Huseyinogu/Buck-ve-Otesi/test_images/circuitphoto.jpeg

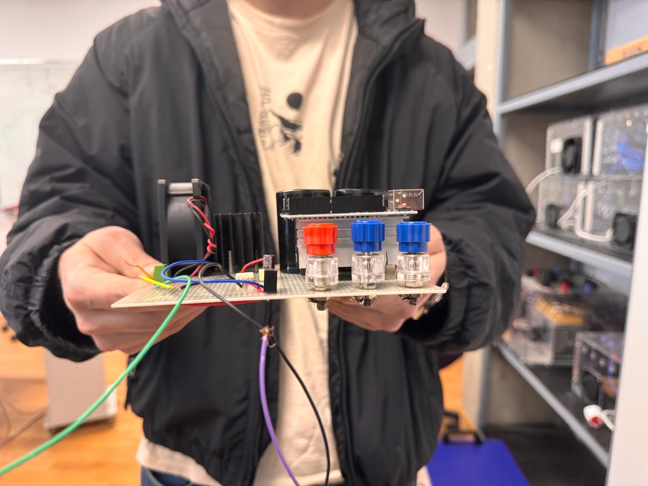
test_images/circuitphoto.jpeg
