Huseyinogu/Buck-ve-Otesi/test_images/circuitconnections.jpeg

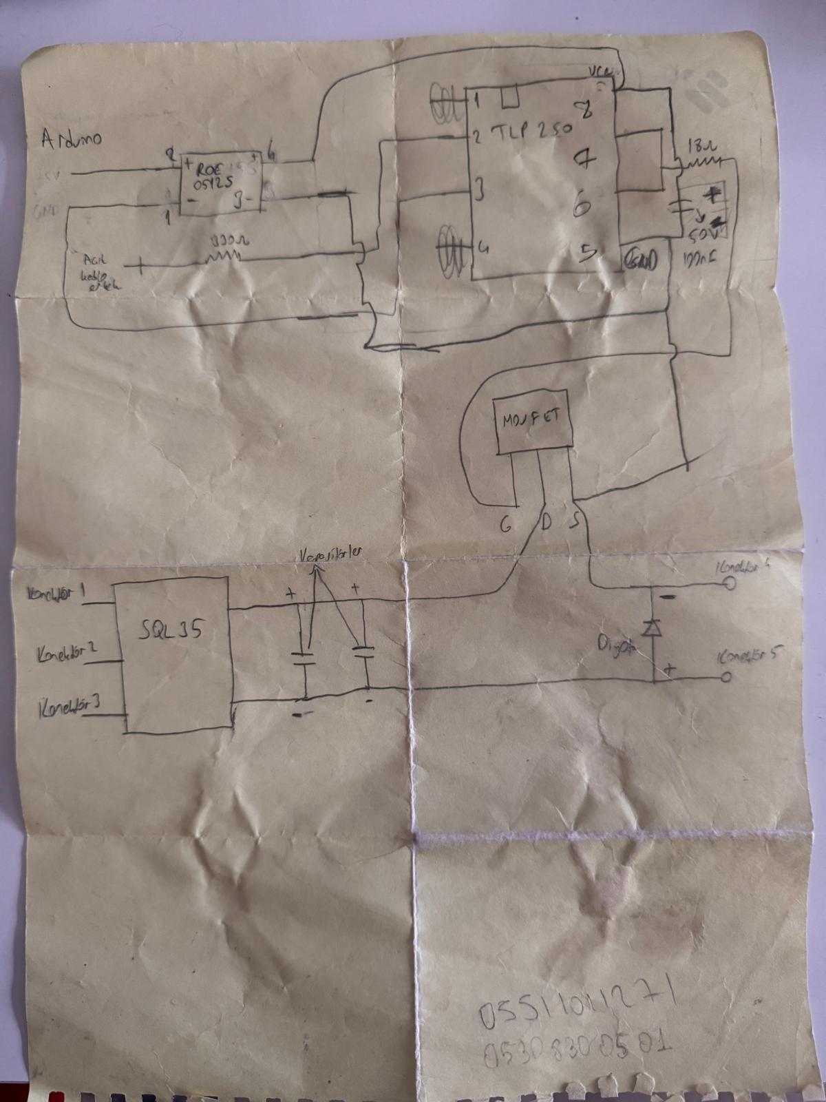
test_images/circuitconnections.jpeg
