Huseyinogu/Buck-ve-Otesi/Gate Driver Selection Final/EE463_Gate_Driver_Selection.pdf

# Evaluation of the TLP250 Optocoupler as a Gate

# Driver for the IXFH80N65X2 MOSFET

## 1 Introduction

This report presents a detailed technical evaluation of the TLP250 optocoupler used as a gate driver for the IXFH80N65X2 power MOSFET. The system operates at a switching frequency (fsw) of 2 kHz with a duty cycle of 0.85. The MOSFET is operated in a high-side

switching configuration, which introduces specific requirements for gate-drive referencing and power supply isolation. The design aims to ensure reliable gate drive operation, correct grounding behavior, acceptable switching performance, and safe operation of both the gate driver and the power device.

## 2 Component and Supply Parameters

### 2.1 MOSFET: IXFH80N65X2

- Drain–source voltage rating: VDSS = 650 V
- Continuous drain current at 25◦C: ID25 = 80 A
- Gate threshold voltage: VGS(th) = 3.5–5.0 V
- Gate-to-source charge: Qgs ≈ 50 nC
- Gate-to-drain (Miller) charge: Qgd ≈ 40 nC
- Total gate charge (datasheet, VGS = 10 V):

Qg ≈ 140 nC

### 2.2 Gate Driver: TLP250

- Maximum peak output current: IO = ±1.5 A
- Maximum input threshold current: IF LH = 5 mA

- Typical LED forward voltage: VF ≈ 1.6 V

## 3 Need for an Isolated DC–DC Converter

### 3.1 Grounding Problem in High-Side Switching

In a high-side switching topology, the source terminal of the MOSFET is not connected to the system ground. Instead, it is tied to the switching node, whose voltage varies dy-namically between the supply voltage and the load voltage during operation. As a result, the source potential is not fixed and may experience large and fast voltage transitions. Gate control of a MOSFET is defined by the gate-to-source voltage (VGS), not the

gate-to-ground voltage. If a non-isolated gate driver supply referenced to system ground were used, the gate driver would be unable to maintain a constant and well-defined VGS. This would lead to incorrect gate drive levels, unreliable switching behavior, and potential overstress of the MOSFET gate oxide.

### 3.2 Floating Gate Drive Requirement

To properly drive a high-side MOSFET, the gate driver supply must be referenced to the MOSFET source terminal and must therefore float with the switching node. This floating behavior ensures that the required positive gate-to-source voltage is maintained regardless of the instantaneous source voltage.
An isolated DC–DC converter provides this floating supply by electrically decoupling the gate-drive power domain from the control and system ground. The isolation prevents ground loops, eliminates common-mode voltage stress on the control circuitry, and allows the gate driver output to move together with the MOSFET source node.

### 3.3 Role of Isolation in System Safety and Reliability

In addition to enabling correct high-side operation, galvanic isolation improves system safety and robustness. The isolation barrier protects low-voltage control electronics from high-voltage transients present in the power stage and prevents destructive current paths caused by ground potential differences. Therefore, the isolated DC–DC converter is not an optional design choice but a functional requirement imposed by the high-side switching configuration.

## 4 Circuit Description and Design Calculations

### 4.1 Input Stage: Microcontroller to TLP250

A 330 Ω resistor is connected between the Arduino PWM output (5 V) and the TLP250

LED input to limit the forward current:

IF =

VIN − VF

Rin

=

5 − 1.6
330

≈ 10.3 mA

This current exceeds the minimum required input current of 5 mA, ensuring reliable optocoupler activation over temperature and supply variations.

### 4.2 Output Stage: TLP250 to MOSFET Gate

An 18 Ω gate resistor (RG) is placed between the TLP250 output pins and the MOSFET

gate to limit the peak gate current and control switching transients.

Ig,peak ≈

VCC
RG

=

15
18

≈ 0.83 A

This current level remains safely below the TLP250 maximum peak current rating.

### 4.3 Gate Charge and Turn-On Time Analysis

MOSFET switching behavior is governed by the total gate charge. According to the datasheet:

Qg = 140 nC

The turn-on transition time can be estimated as:

ton ≈

Qg

Ig,peak

=

140 nC
0.83 A

≈ 169 ns

This value includes the gate-to-source charging interval, the Miller plateau, and the post-Miller gate voltage rise.

### 4.4 Turn-Off Behavior

During turn-off, the gate charge is discharged through the same gate resistor. Given the switching frequency of 2 kHz, the available off-time of approximately 75 µs is several orders of magnitude longer than the required discharge time, ensuring full turn-off before the next switching cycle.

### 4.5 Power Supply Decoupling

Local decoupling capacitors are placed between VCC and GND of the TLP250:

- 0.1 µF ceramic capacitor for high-frequency decoupling
- 0.47 µF capacitor acting as a local energy buffer

## 5 Conclusion

The analysis demonstrates that the TLP250 optocoupler is suitable for driving the IXFH80N65X2 MOSFET in a high-side switching configuration at a switching frequency of 2 kHz. The
use of an isolated DC–DC converter is essential to provide a floating gate-drive supply, eliminate grounding conflicts, and ensure a well-defined gate-to-source voltage under all operating conditions. By correctly accounting for the total gate charge of 140 nC, the estimated switching times remain negligible relative to the switching period, confirming the validity and robustness of the proposed gate drive design.
