Huseyinogu/Buck-ve-Otesi/test_images/160V_Test_DC_Supply.jpeg

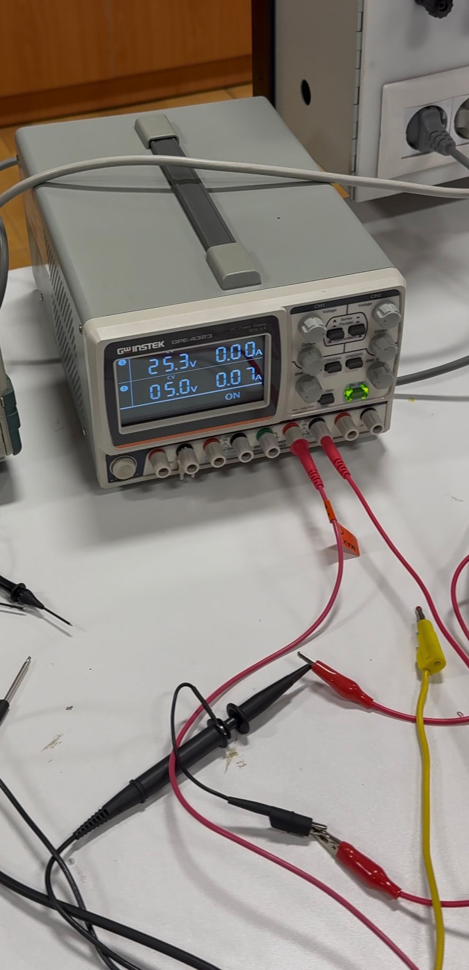
test_images/160V_Test_DC_Supply.jpeg
