Huseyinogu/Buck-ve-Otesi/test_images/160V_Test_MOSFET_Thermal_Camera.jpeg

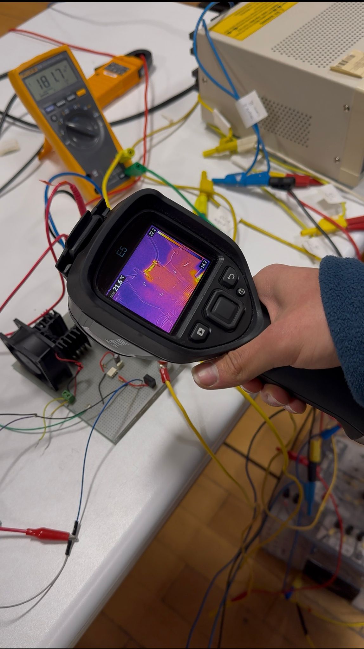
test_images/160V_Test_MOSFET_Thermal_Camera.jpeg
