Huseyinogu/Buck-ve-Otesi/test_images/160V_Test_Multimeter.jpeg

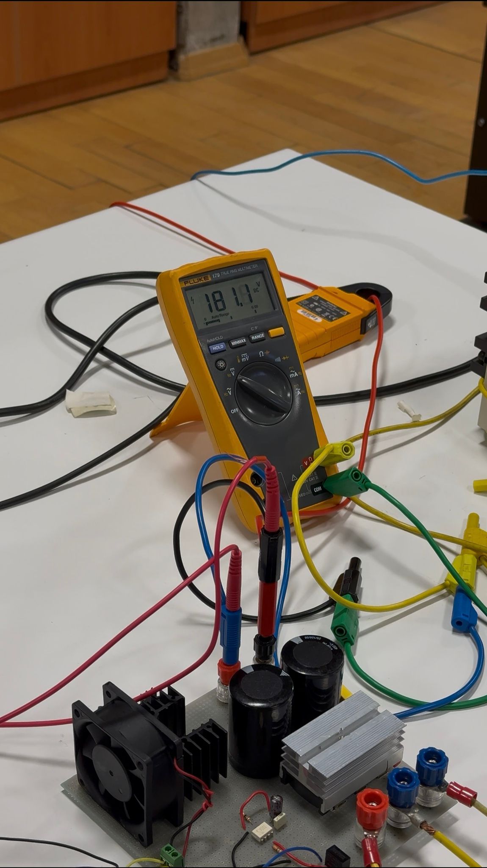
test_images/160V_Test_Multimeter.jpeg
