Huseyinogu/Buck-ve-Otesi/test_images/160V_Test_Oscilloscope.jpeg

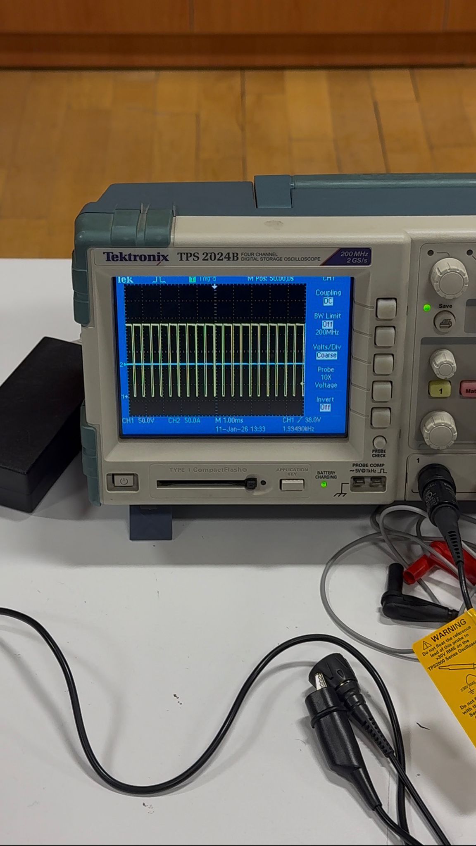
test_images/160V_Test_Oscilloscope.jpeg
