Huseyinogu/Buck-ve-Otesi/test_images/circuit.jpeg

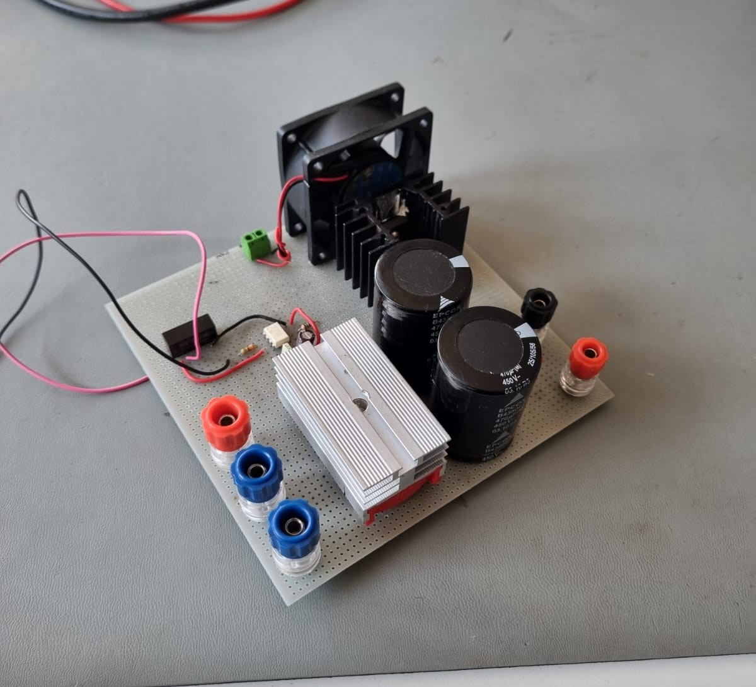
test_images/circuit.jpeg
