Huseyinogu/Buck-ve-Otesi/test_images/circuitphoto2.jpeg

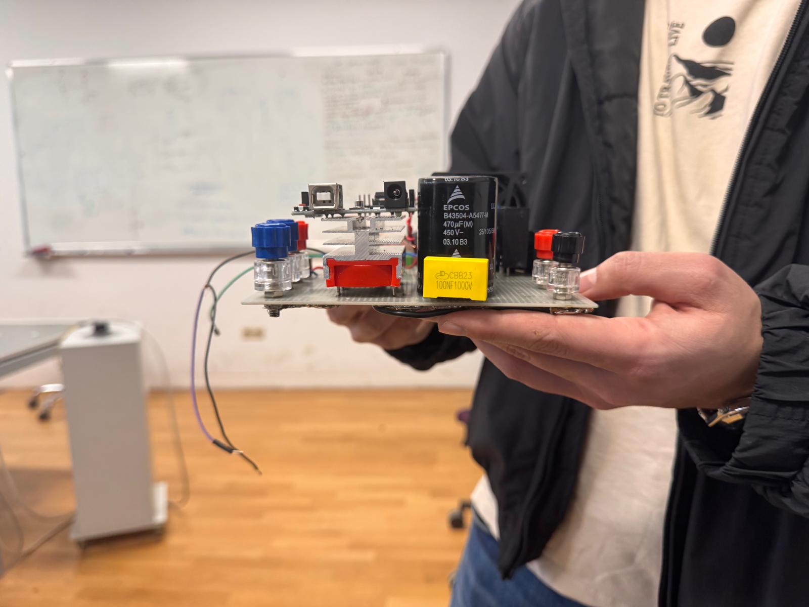
test_images/circuitphoto2.jpeg
