Huseyinogu/Buck-ve-Otesi/test_images/circuitphototop.jpeg

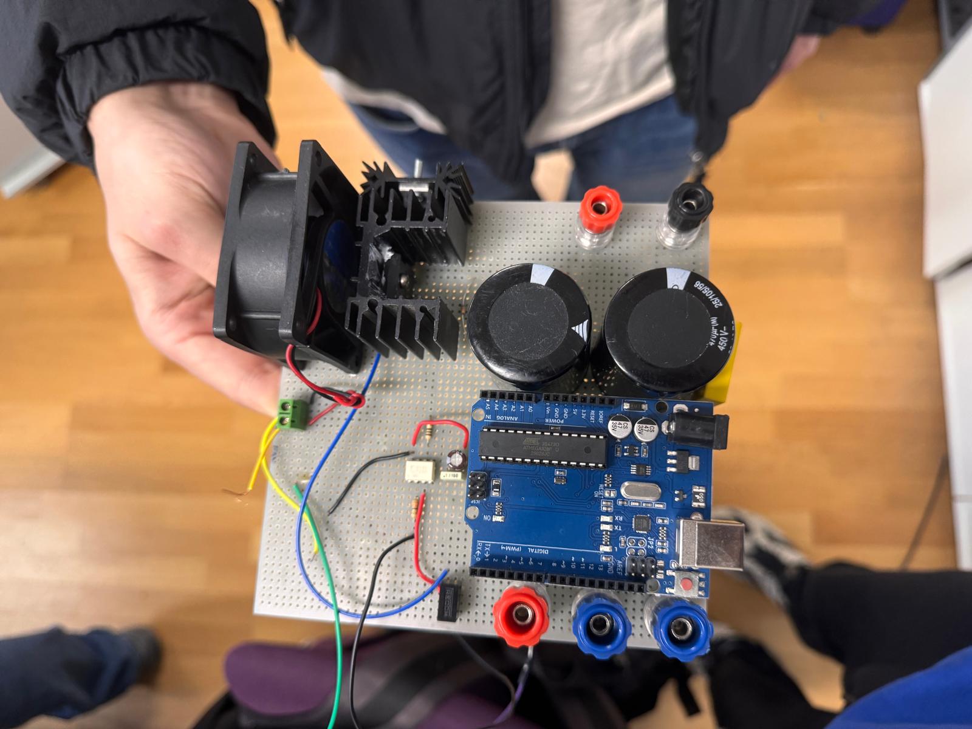
test_images/circuitphototop.jpeg
