Huseyinogu/Buck-ve-Otesi/test_images/Diode Rectifier in Kettle Bonus.jpeg

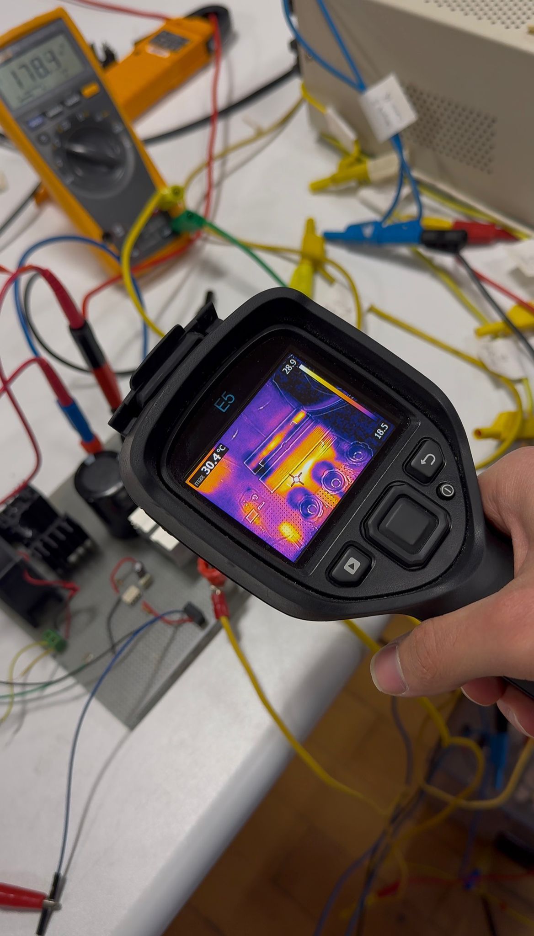
test_images/Diode Rectifier in Kettle Bonus.jpeg
