Huseyinogu/Buck-ve-Otesi/test_images/IMG_5116.jpeg

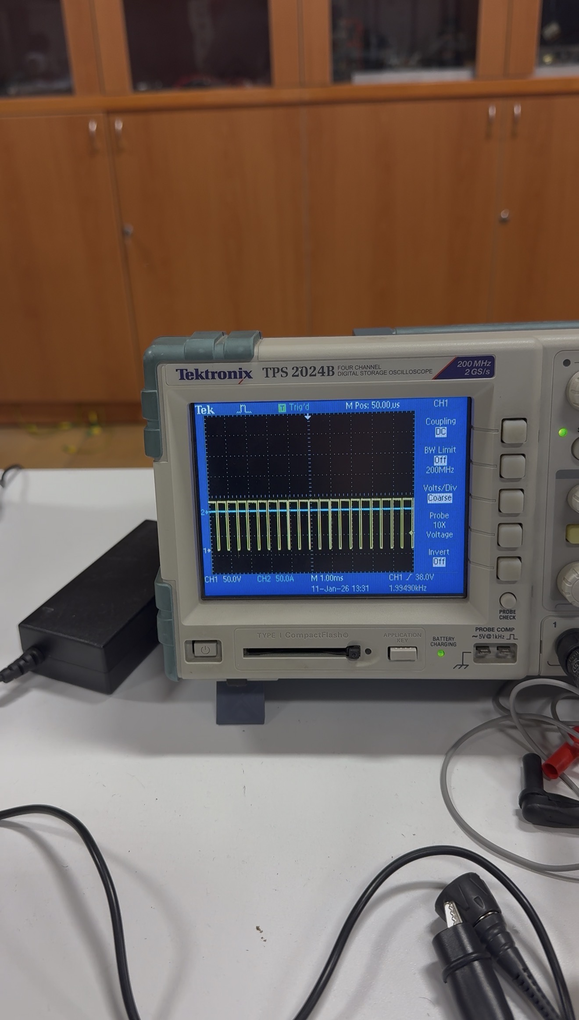
test_images/IMG_5116.jpeg
