Huseyinogu/Buck-ve-Otesi/test_images/IMG_5117.jpeg

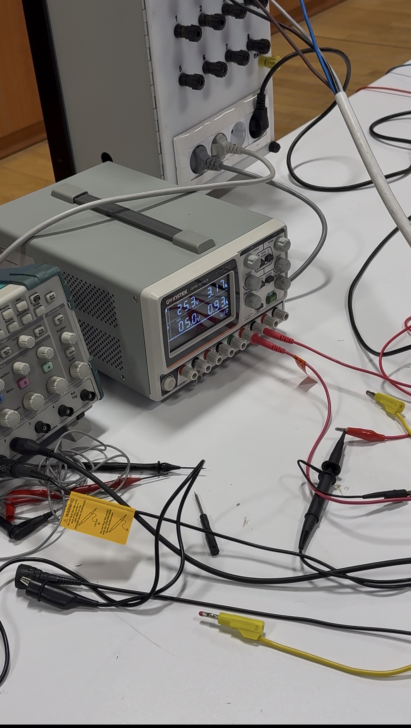
test_images/IMG_5117.jpeg
