Huseyinogu/Buck-ve-Otesi/test_images/Kettle and Oscilloscope in Kettle Bonus (initially).jpeg

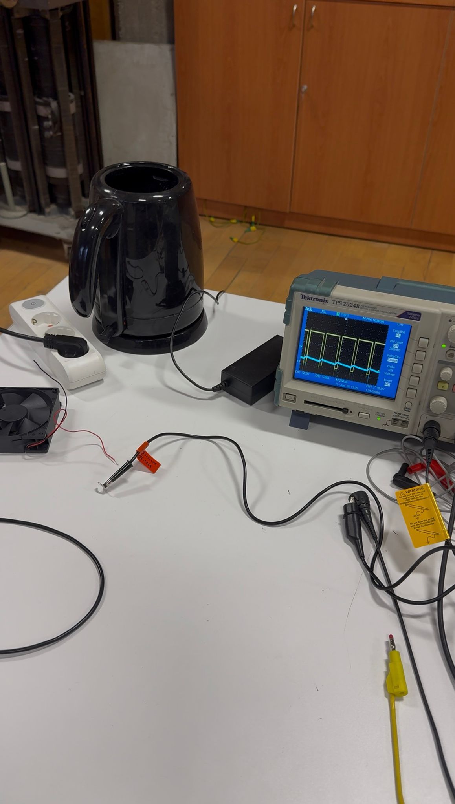
test_images/Kettle and Oscilloscope in Kettle Bonus (initially).jpeg
