Huseyinogu/Buck-ve-Otesi/test_images/Kettle Heating Up (kettle bonus).jpeg

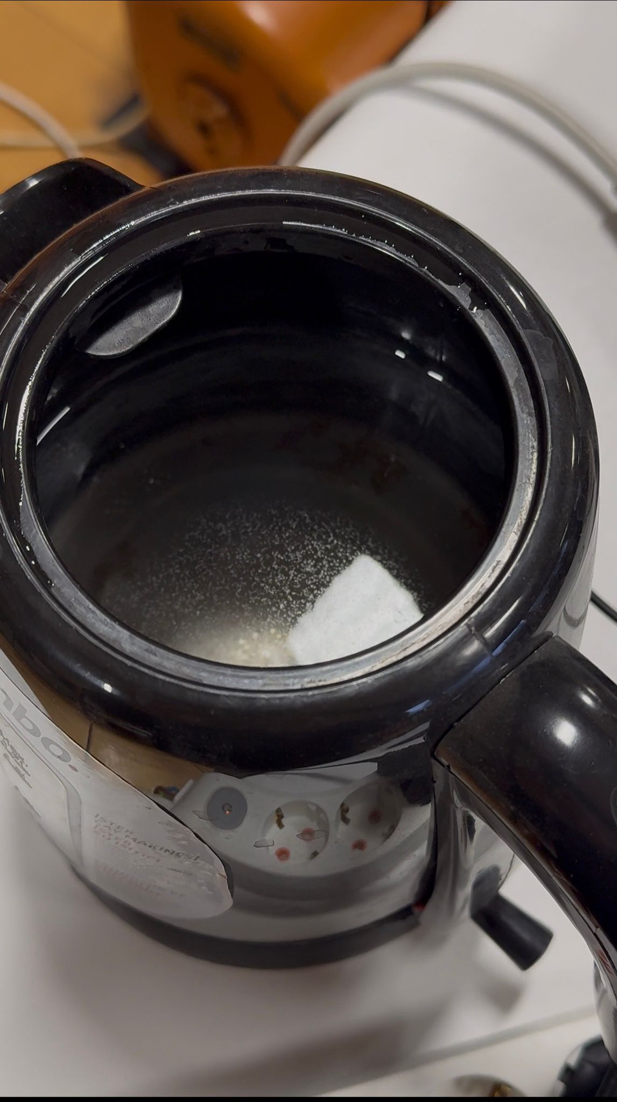
test_images/Kettle Heating Up (kettle bonus).jpeg
