Huseyinogu/Buck-ve-Otesi/test_images/MOSFET in Kettle Bonus.jpeg

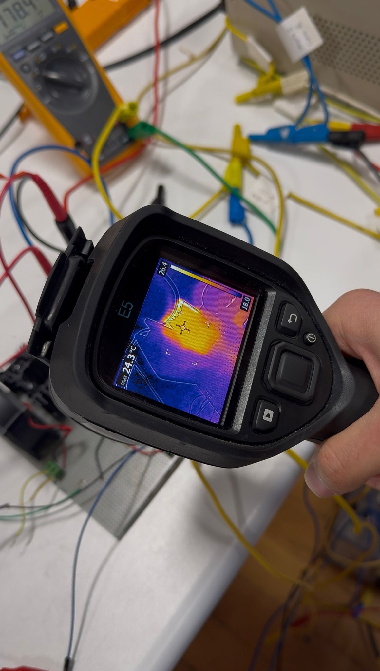
test_images/MOSFET in Kettle Bonus.jpeg
