Huseyinogu/Buck-ve-Otesi/test_images/Multimeter in Kettle Bonus.jpeg

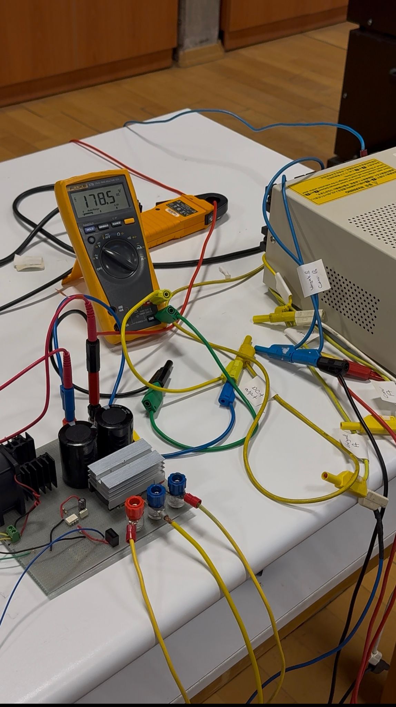
test_images/Multimeter in Kettle Bonus.jpeg
