Huseyinogu/Buck-ve-Otesi/test_images/Oscilloscope Footage in Kettle Bonus.jpeg

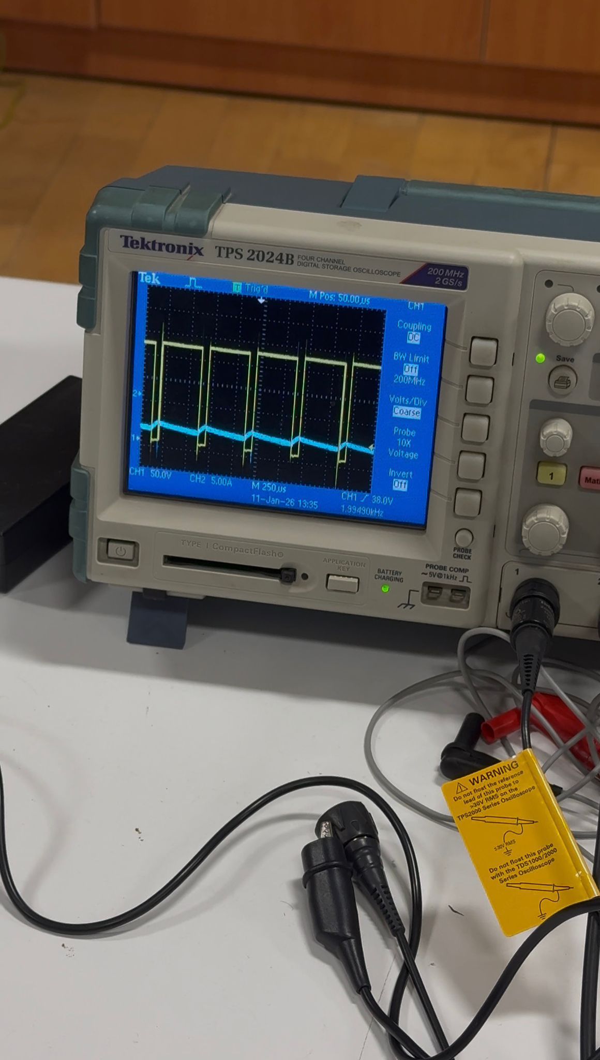
test_images/Oscilloscope Footage in Kettle Bonus.jpeg
