Huseyinogu/Buck-ve-Otesi/test_images/Us in Kettle Bonus.jpeg

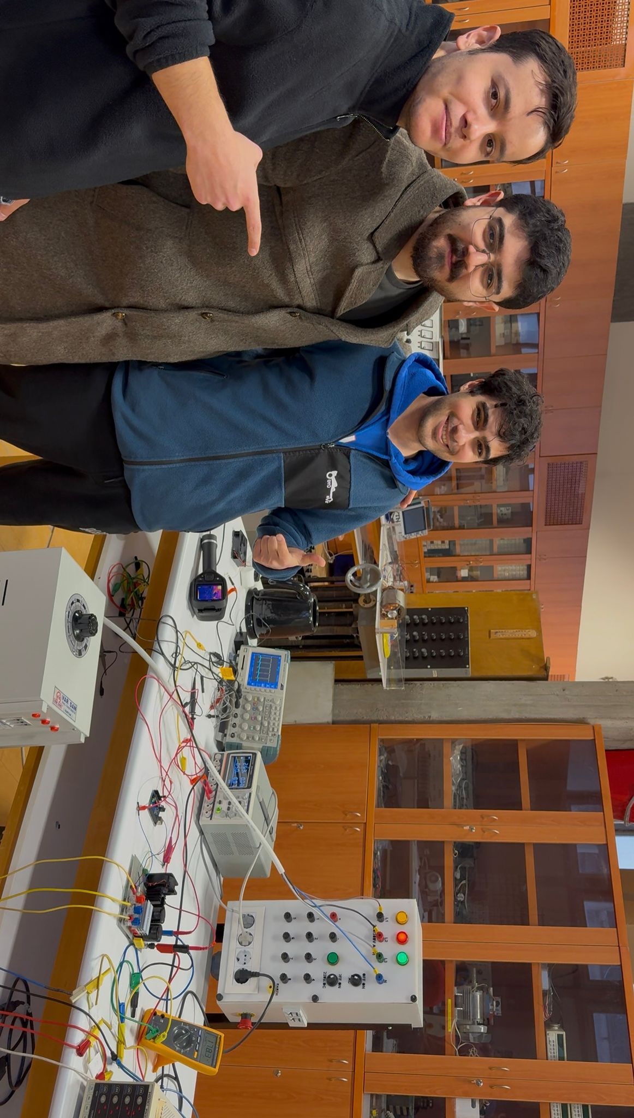
test_images/Us in Kettle Bonus.jpeg
