Huseyinogu/Buck-ve-Otesi/test_images/Wattmeter Footage in Kettle Bonus.jpeg

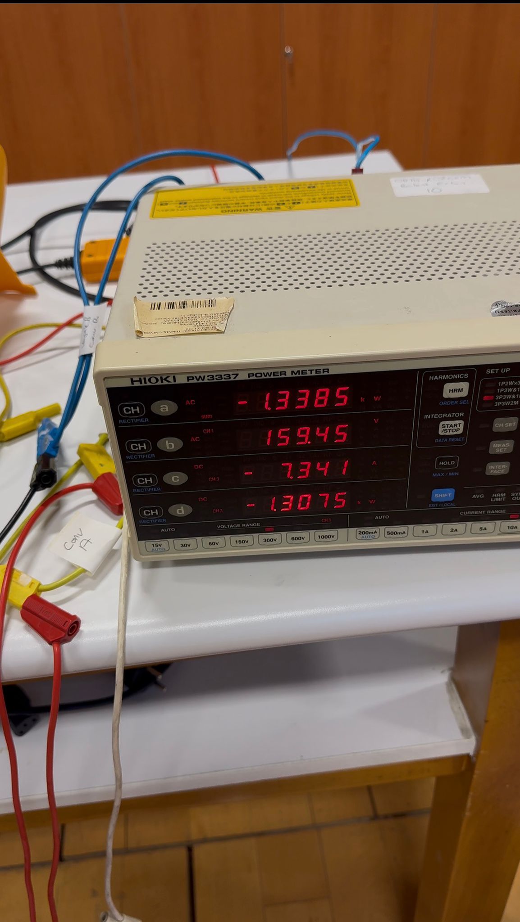
test_images/Wattmeter Footage in Kettle Bonus.jpeg
