Huseyinogu/Buck-ve-Otesi/Thermal Calculations and Selections/Buck_ve_Otesi_Thermal_Calculation_Selection.pdf

## MIDDLE EAST TECHNICAL UNIVERSITY Department of Electrical and Electronics Engineering

### EE463 – Power Electronics Hardware Project

# Design and Thermal Analysis of a

# DC-DC Buck Converter

## Presented by Group:

# “Buck ve Otesi” ¨

## Project Members:

Alihan KALE | 2516334
H¨useyin OGUZ ˘ | 2516623

## Yunus TOSUN 2517084

## January 2026

## Contents

1 Component Selection and Revised Thermal Analysis | 2
A Appendix A: Component Datasheet | 4

## 1 Component Selection and Revised Thermal Analysis

### 1.1 Deviation from Initial Design (Component Substitution)

The initial design specifications called for the IXGH24N60C4D1 IGBT. However, due to a supply chain substitution, the IXFH80N65X2 (Ultra-Junction X2-Class Power MOSFET) was received and implemented.
A comparative analysis confirmed that the substituted MOSFET offers superior characteristics for this application (VDSS = 650V , ID25 = 80A, RthJC = 0.14◦C/W). Consequently, the thermal calculations were revised to account for the resistive nature of the MOSFET.

### 1.2 Power Loss Calculation (IXFH80N65X2)

Unlike IGBTs, which are modeled with a relatively constant voltage drop (VCE), the conduction loss of a MOSFET depends on its On-State Resistance (RDS(on)).
It is crucial to note that RDS(on) is not a constant value; it varies significantly with the junction temperature (TJ ). MOSFETs exhibit a Positive Temperature Coefficient, meaning their resistance increases as they heat up. Relying solely on the datasheet’s nominal resistance at 25◦C would lead to a severe underestimation of power losses and potentially dangerous thermal runaway.

### 1.2.1 Conduction Losses (Pcond) and Effective Resistance

To ensure a realistic and safe thermal design, an ”Effective Hot Resistance” (Rhot) was calculated. This value represents the device’s resistance at the target operating temperature, rather than its cold state.
- Nominal Resistance (Rcold): The datasheet specifies a maximum RDS(on) of 38 mΩ at TJ = 25◦C.
- Thermal Adjustment Factor: According to Fig. 4: RDS(on) Normalized vs. Junction Temperature in the datasheet, the resistance increases by a factor of ap-proximately 2.2 when the junction temperature approaches the design limit of 125◦C.

Using this normalization factor, the effective resistance used for the power calculation is:
Rhot = RDS(on),25◦C × 2.2 = 38mΩ × 2.2 ≈ 83.6mΩ (0.0836 Ω) | (1)

Consequently, the conduction power loss at the load current of 12A is:

Pcond = I

2

load × Rhot = 12² × 0.0836 = 144 × 0.0836 ≈ 12.04 W | (2)

### 1.2.2 Switching Losses (Psw)

The switching losses are determined by the transition times provided in the datasheet (ton ≈ 56ns, tof f ≈ 81ns) and the switching frequency (2kHz).

Psw ≈

1
2
VbusIload(ttotal)fsw | (3)

Psw ≈ 0.5 × 400 × 12 × (137 × 10⁻⁹
) × 2000 ≈ 0.66 W | (4)

### 1.2.3 Total Power Dissipation

Ptotal = Pcond + Psw = 12.04 W + 0.66 W ≈ 12.7 W | (5)

### 1.3 Heatsink Selection and Cooling Strategy

To maintain the junction temperature below the safety limit of 110◦C, the thermal resistance requirement was calculated using the derived total power loss.
Thermal Parameters:
- RθJC (Junction-to-Case): 0.14 ◦C/W (Directly from datasheet).
- RθCS (Case-to-Sink): 1.0 ◦C/W (Conservative estimate for the isolation pad).

Calculation:

RθSA ≤

TJ,max − Tamb

Ptotal

− (RθJC + RθCS) | (6)

RθSA ≤

110 − 30
12.7
− (0.14 + 1.0) | (7)

RθSA ≤

80
12.7
− 1.14 ≈ 6.30 − 1.14 = 5.16 ◦C/W | (8)

### 1.4 Conclusion on Main Switching Cooling

The calculation dictates that a heatsink with a thermal resistance of 5.16 ◦C/W or lower is required.
Since the standard passive aluminum heatsinks in the laboratory inventory typically provide 10–15 ◦C/W (which is insufficient for this load), the Active Cooling Solution (Heatsink + Fan) remains mandatory to ensure the MOSFET operates within its Safe Operating Area (SOA).

### 1.5 Auxiliary Thermal Protection: Freewheeling Diode

In addition to the main switching element, the thermal stability of the freewheeling diode was evaluated as a critical factor for the system’s long-term reliability.
Although the theoretical power dissipation analysis suggested that the diode operates within its Safe Operating Area (SOA), practical considerations regarding ambient temperature fluctuations and continuous high-load operation necessitated a conservative approach.
To eliminate any risk of thermal runaway and to minimize the thermal stress on the junction, a dedicated passive aluminum heatsink was integrated onto the diode package. This preventive measure serves two key purposes:
1. Derating: It keeps the operational junction temperature (TJ ) significantly below the maximum rating, extending the component’s lifespan.
2. Transient Stability: It provides a larger thermal mass to absorb transient heat spikes during rapid load changes.

Consequently, this auxiliary cooling solution ensures that the freewheeling diode remains thermally stable, safeguarding the overall integrity of the Buck Converter circuit.

## A Appendix A: Component Datasheet

The technical specifications for the substituted component, IXFH80N65X2, are at-tached below for reference.

## X2-Class HiPerFETTM Power MOSFET

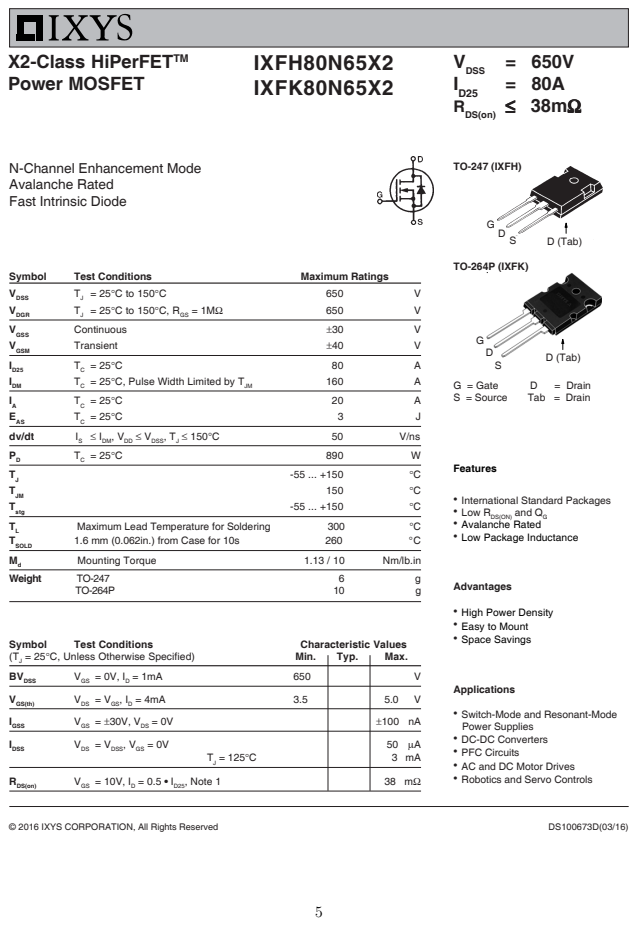
[picture p22: page 6]
© 2016 IXYS CORPORATION, All Rights Reserved; IXFH80N65X2 IXFK80N65X2; VDSS; RDS(on) ≤ 38mΩ; Symbol; Test Conditions; Characteristic Values; = 25°C, Unless Otherwise Specified); Min.; Typ.; Max.; BVDSS; VGS = 0V, ID = 1mA; VGS(th); VDS = VGS, ID = 4mA; GSS; VGS = ±30V, VDS = 0V; DSS; VDS = VDSS, VGS = 0V; RDS(on); VGS = 10V, ID = 0.5 • ID25, Note 1; Maximum Ratings; VDGR; TJ = 25°C to 150°C, RGS = 1MΩ; VGSS; Continuous; VGSM; Transient; TC = 25°C, Pulse Width Limited by TJM; EAS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

N-Channel Enhancement Mode
Avalanche Rated
Fast Intrinsic Diode

● International Standard Packages
● Low RDS(ON) and QG ● Avalanche Rated

● Low Package Inductance

● High Power Density
● Easy to Mount
● Space Savings

● Switch-Mode and Resonant-Mode
Power Supplies
● DC-DC Converters
● PFC Circuits
● AC and DC Motor Drives
● Robotics and Servo Controls

## IXFH80N65X2 IXFK80N65X2

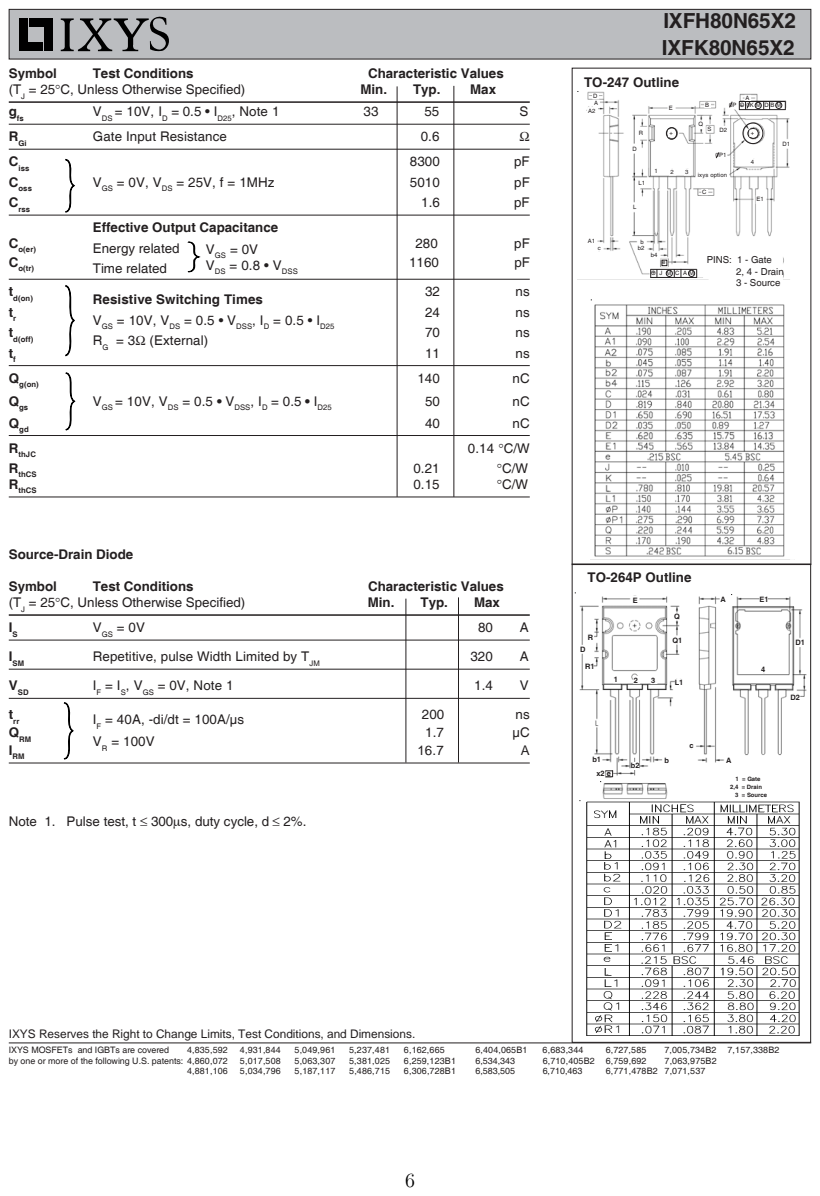
[picture p23: page 7]
IXYS MOSFETs and IGBTs are covered; by one or more of the following U.S. patents: 4,860,072 5,017,508; Symbol; Test Conditions; Characteristic Values; = 25°C, Unless Otherwise Specified); Min.; Typ.; Max; VGS = 0V; Repetitive, pulse Width Limited by TJM; VSD; F = IS, VGS = 0V, Note 1; trr; QRM; TO-264P Outline; Terminals: 1 = Gate 2,4 = Drain 3 = Source; TO-247 Outline; ixys option; PINS: 1 - Gate 2, 4 - Drain 3 - Source; gfs; VDS = 10V, ID = 0.5 • ID25, Note 1; RGi; Gate Input Resistance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

Effective Output Capacitance
Energy related
Time related

Resistive Switching Times
VGS = 10V, VDS = 0.5 • VDSS, ID = 0.5 • ID25
RG = 3Ω (External)

Source-Drain Diode

Note 1. Pulse test, t ≤ 300µs, duty cycle, d ≤ 2%.

IXYS Reserves the Right to Change Limits, Test Conditions, and Dimensions.

## IXFH80N65X2 IXFK80N65X2

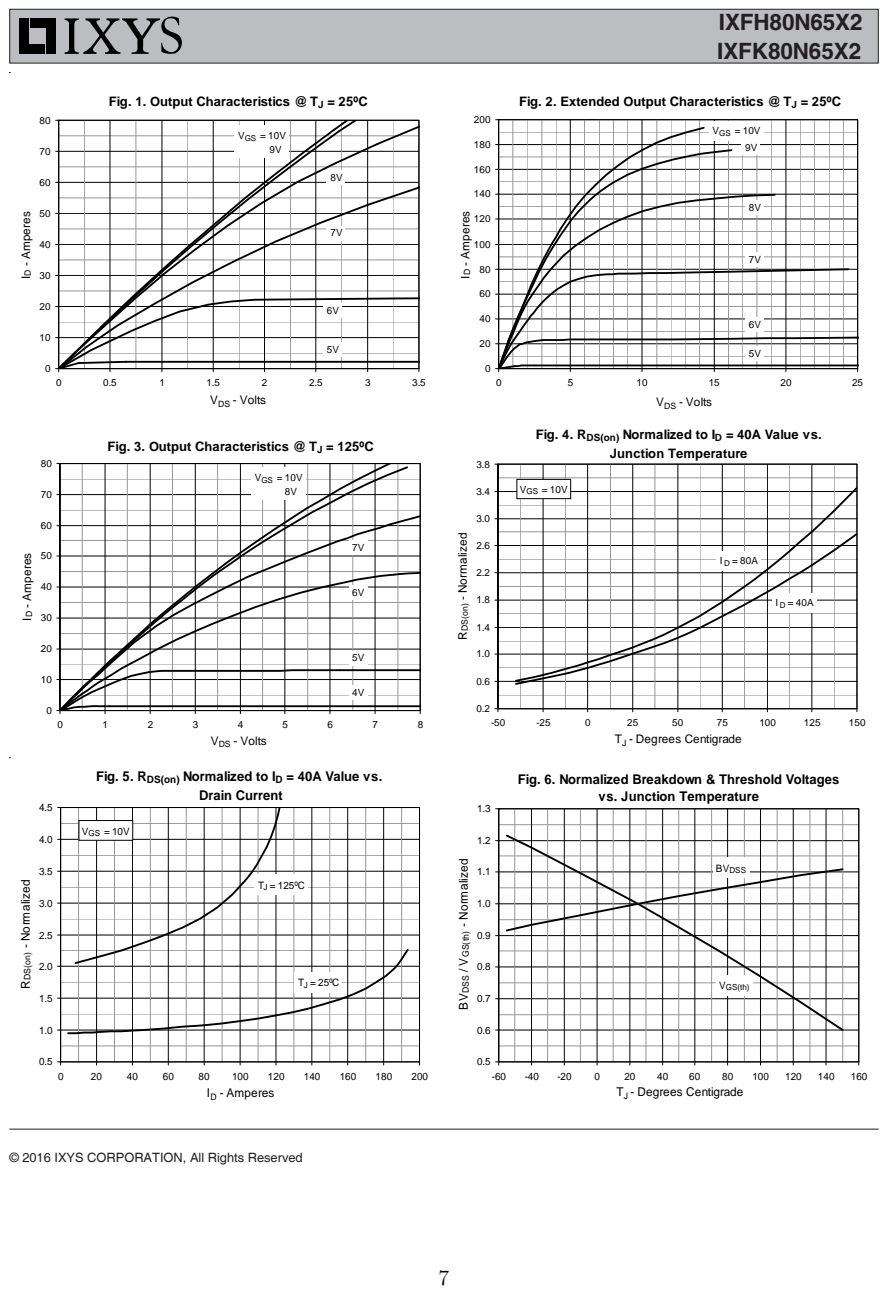
[picture p24: page 8]
VDS - Volts; ID - Amperes; VGS = 10V; VGS = 10V 8V; Junction Temperature; VGS; Drain Current

Fig. 1. Output Characteristics @ TJ = 25ºC

Fig. 2. Extended Output Characteristics @ TJ = 25ºC

Fig. 3. Output Characteristics @ TJ = 125ºC

Fig. 4. RDS(on) Normalized to ID = 40A Value vs.

RDS(on) - Normalized

TJ - Degrees Centigrade

Fig. 5. RDS(on) Normalized to ID = 40A Value vs.

Fig. 6. Normalized Breakdown & Threshold Voltages

vs. Junction Temperature

BVDSS / VGS(th) - Normalized

BVDSS

VGS(th)

© 2016 IXYS CORPORATION, All Rights Reserved

## IXFH80N65X2 IXFK80N65X2

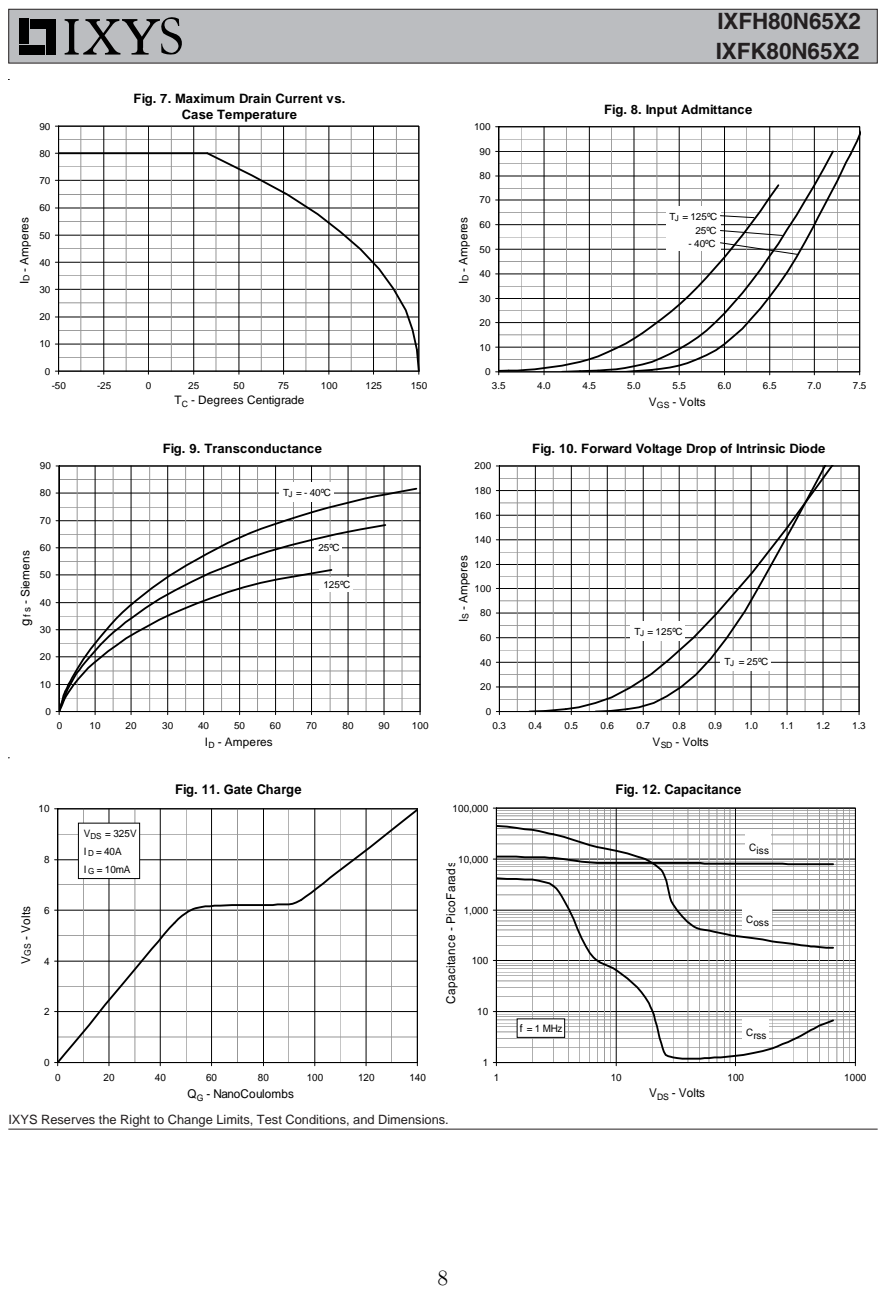
[picture p25: page 9]
VGS - Volts; ID - Amperes; Case Temperature; Fig. 9. Transconductance; g f s - Siemens; VSD - Volts; IS - Amperes; QG - NanoCoulombs; Fig. 12. Capacitance; VDS - Volts; Capacitance - PicoFarads; Coss

Fig. 7. Maximum Drain Current vs.

Fig. 8. Input Admittance

TJ | = 125ºC
25ºC
- 40ºC

TC - Degrees Centigrade

Fig. 10. Forward Voltage Drop of Intrinsic Diode

Fig. 11. Gate Charge

VDS = 325V
I D = 40A
I G = 10mA

Ciss

f = 1 MHz | Crss

IXYS Reserves the Right to Change Limits, Test Conditions, and Dimensions.

## IXFH80N65X2 IXFK80N65X2

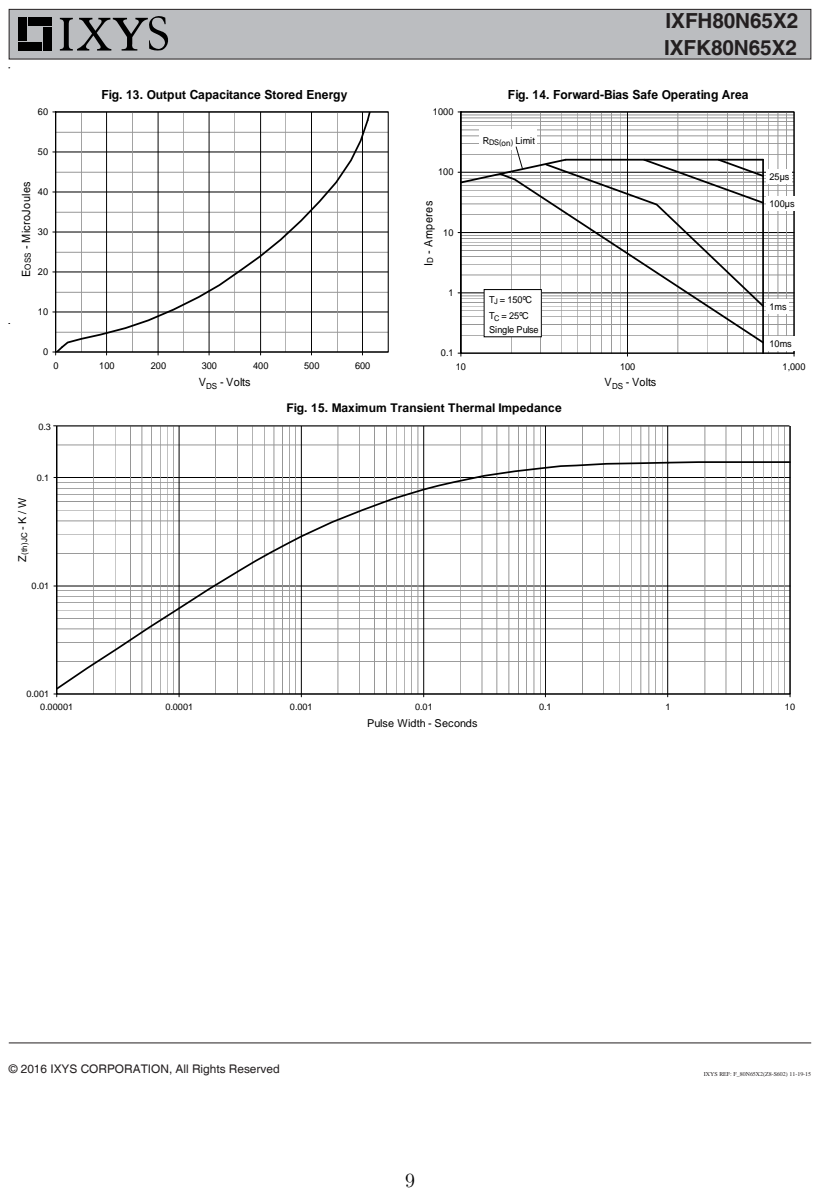
[picture p26: page 10]
IXYS REF: F_80N65X2(Z8-S602) 11-19-15; VDS - Volts; ID - Amperes; EOSS - MicroJoules

Fig. 13. Output Capacitance Stored Energy

Fig. 14. Forward-Bias Safe Operating Area

RDS(on) Limit

TJ = 150ºC
TC = 25ºC
Single Pulse

Fig. 15. Maximum Transient Thermal Impedance

Fig. 15. Maximum Transient Thermal Impedance aaaaa 0.3

Pulse Width - Seconds

© 2016 IXYS CORPORATION, All Rights Reserved
