Huseyinogu/Buck-ve-Otesi/circuit topologies/kicad_draft_forpcb.kicad_sch

## KiCad design circuit topologies/kicad_draft_forpcb.kicad_sch (2025-12-05)

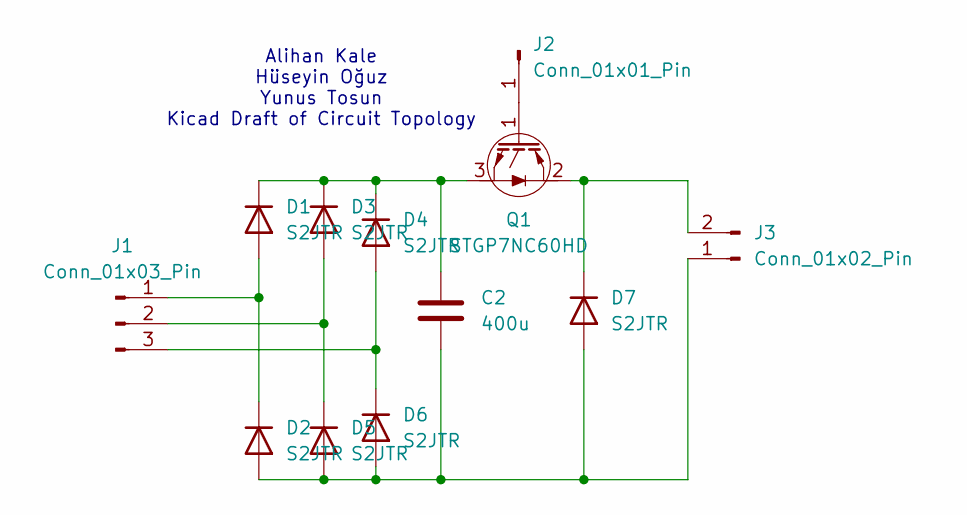
[picture p27: schematic kicad_draft_forpcb.kicad_sch]

Parts:
C2: 400u; C_0603_1608Metric
D1, D2, D3, D4, D5, D6, D7: S2JTR; D_SMB
J1: Conn_01x03_Pin; TerminalBlock_TE_1x02_P5.08mm
J2: Conn_01x01_Pin; TerminalBlock_TE_1x02_P5.08mm
J3: Conn_01x02_Pin; TerminalBlock_TE_1x02_P5.08mm
Q1: STGP7NC60HD; TO-220-3_Vertical

Connections:
unnamed: C2.1, D1.1 (K), D3.1 (K), D4.1 (K), Q1.3 (E)
unnamed: C2.2, D2.2 (A), D5.2 (A), D6.2 (A), D7.2 (A), J3.1
unnamed: D1.2 (A), D2.1 (K), J1.1
unnamed: D3.2 (A), D5.1 (K), J1.2
unnamed: D4.2 (A), D6.1 (K), J1.3
unnamed: D7.1 (K), J3.2, Q1.2 (C)
unnamed: J2.1, Q1.1 (G)

Notes on the sheet:
Alihan Kale Hüseyin Oğuz Yunus Tosun Kicad Draft of Circuit Topology
