Huseyinogu/Buck-ve-Otesi/(commit log)

2025-12-05 Circuit topologies
    [kicad_draft_forpcb.kicad_sch]
2025-12-26 The report for the gate driver selection
2026-01-07 Latex code for gate driver selection
2026-01-07 Create Gate Driver Selection
2026-01-07 Gate Driver Selection Folder
2026-01-07 Gate Driver Selection Report
2026-01-07 Latex Code for Gate Driver Selection Report
2026-01-14 Photo of the circuit
2026-01-14 Photo of the circuit2
2026-01-14 Top photo of the circuit
2026-01-14 Circuit connections
2026-01-14 90 volt ilk deneme
2026-01-14 Tam güç (160 volt)
2026-01-14 Ogün Hoca’s Data Sheet
    This sheet includes different cases for different loads.
2026-01-14 Arduino Duty Cycle Slow Start 10.2sec
2026-01-14 160V input test
2026-01-14 view of circuit used in the report
2026-01-14 Oscilloscope and DC Supply Footqge only Rload
    Footage of oscilloscope and DC power supply when only Rload is connected to the load
