Huseyinogu/Buck-ve-Otesi/test_images/Ogün Hoca's Datasheet.jpeg

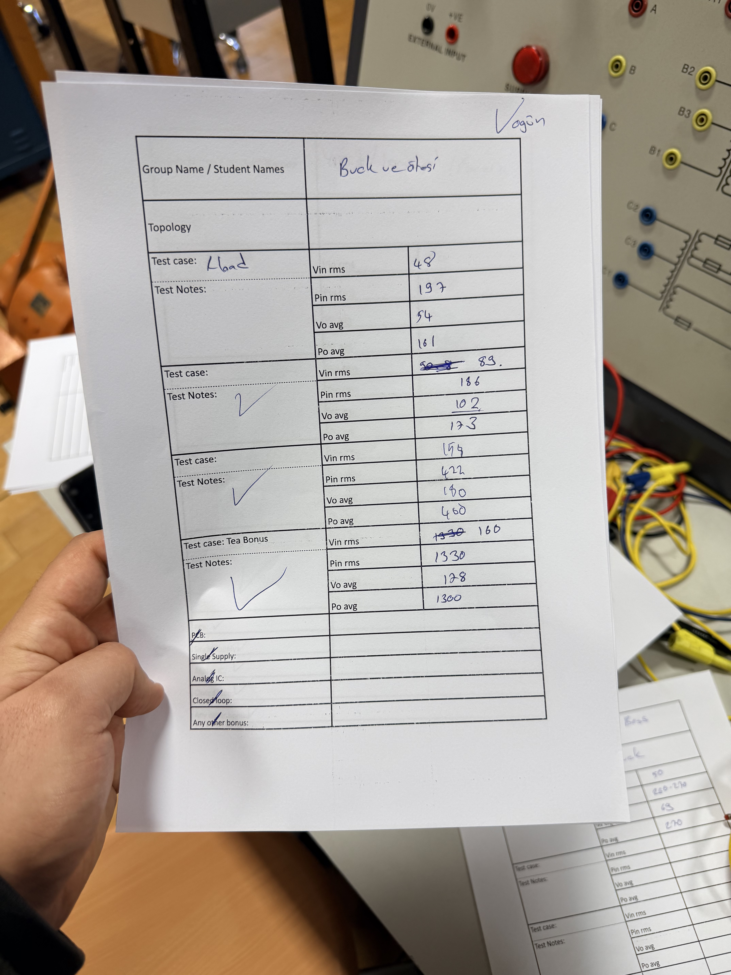
test_images/Ogün Hoca's Datasheet.jpeg
